rocketproplab/Remove-Before-Flight/README.md

# Remove Before Flight
"Remove Before Flight" RBF-1 is a 2000 lbf Liquid Oxygen, Liquid Natural Gas engine currently being designed and developed by the Rocket Propulsion Laboratory.
