rocketproplab/Remove-Before-Flight/CAD/Igniter_Assembly_3_11.SLDASM

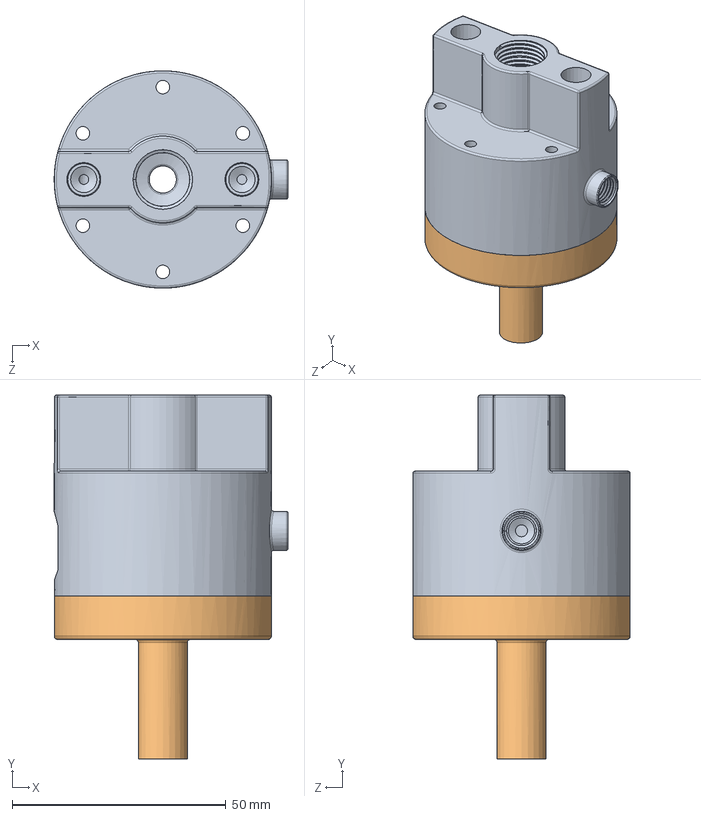
[picture p15: CAD file, 2017-03-30]
CAD/Igniter_Assembly_3_11.SLDASM
54.6 x 85.1 x 50.8 mm
Igniter_Top
Ingiter_Tube2
