rocketproplab/Remove-Before-Flight/CAD/IgniterBottom.SLDPRT

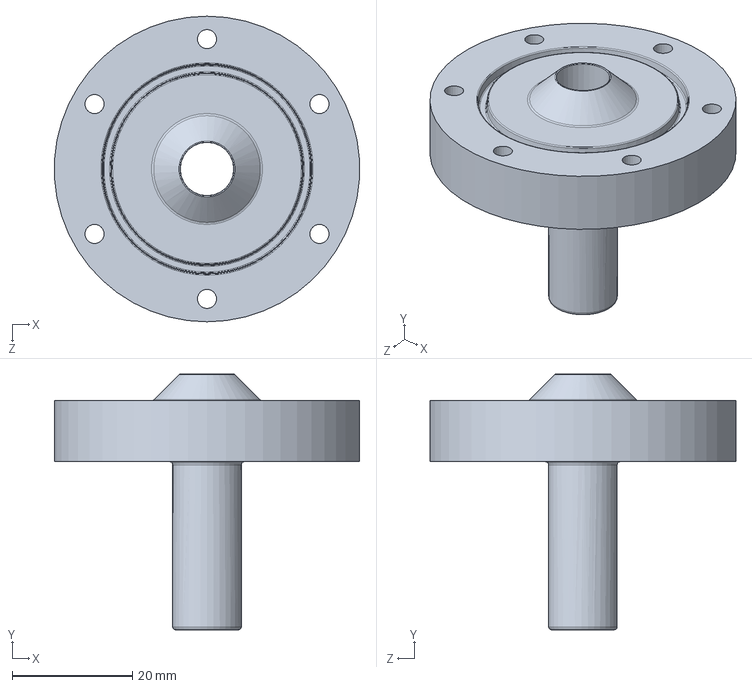
[picture p16: CAD file, 2017-03-30]
CAD/IgniterBottom.SLDPRT
50.7 x 42.5 x 50.8 mm
