rocketproplab/Remove-Before-Flight/CAD/Igniter_Top.SLDPRT

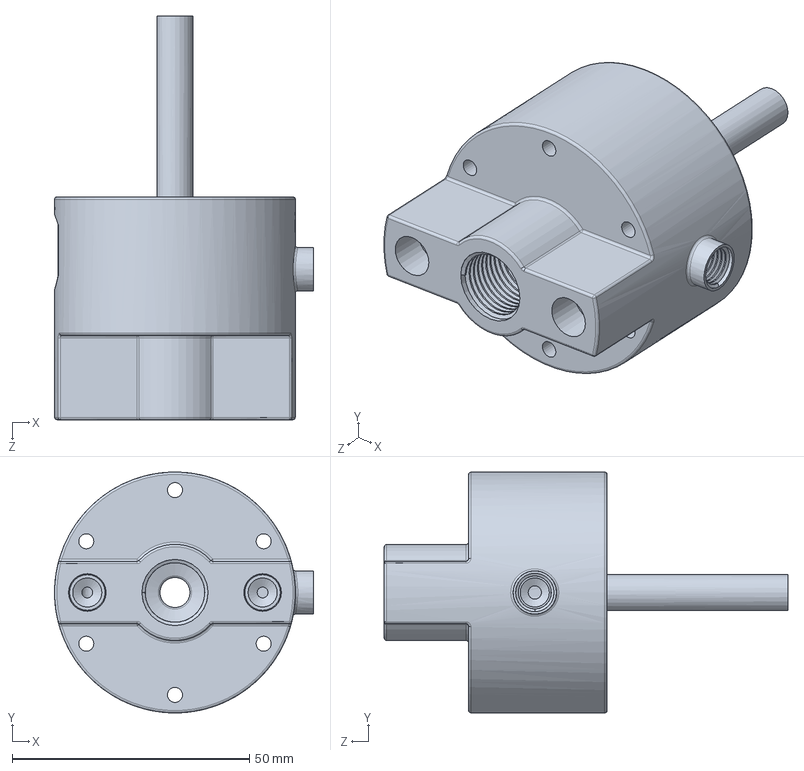
[picture p17: CAD file, 2017-03-30]
CAD/Igniter_Top.SLDPRT
54.6 x 50.8 x 85.1 mm
