rocketproplab/Remove-Before-Flight/CAD/Igniter_Flange.SLDPRT

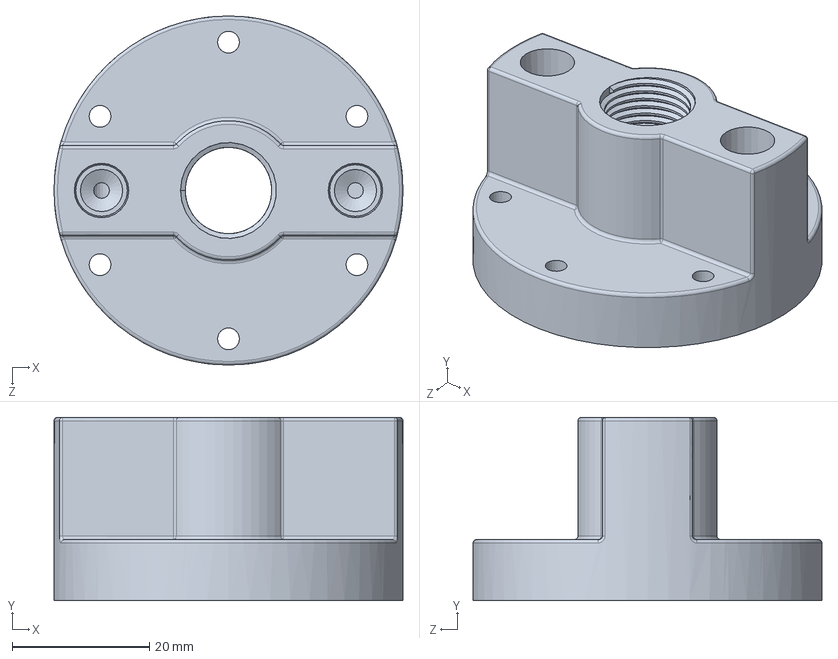
[picture p18: CAD file, 2017-03-30]
CAD/Igniter_Flange.SLDPRT
50.8 x 26.7 x 50.8 mm
