rocketproplab/Remove-Before-Flight/CAD/Igniter_Chamber2.SLDPRT

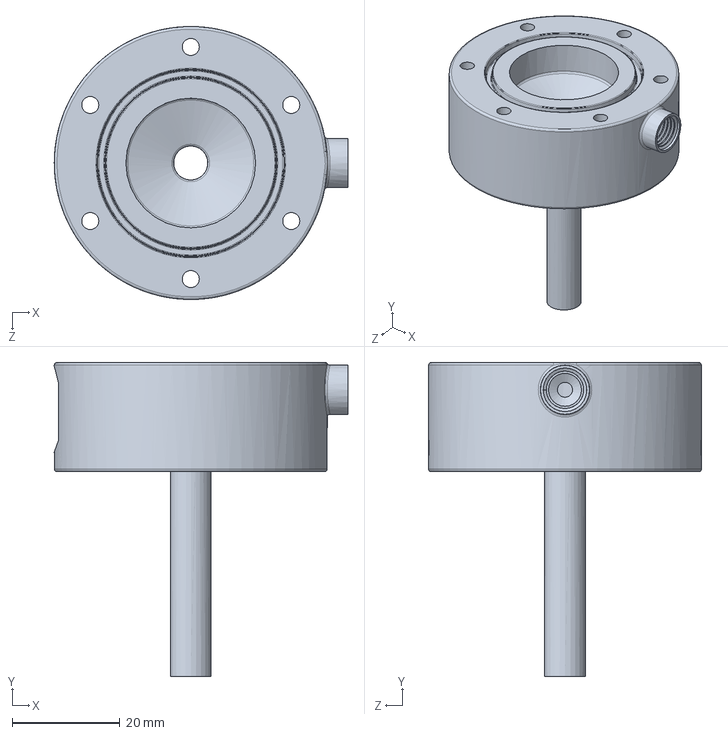
[picture p19: CAD file, 2017-03-30]
CAD/Igniter_Chamber2.SLDPRT
54.6 x 58.4 x 50.8 mm
