rocketproplab/Remove-Before-Flight/CAD/RPL00001-02_TCA_1000lbf.SLDPRT

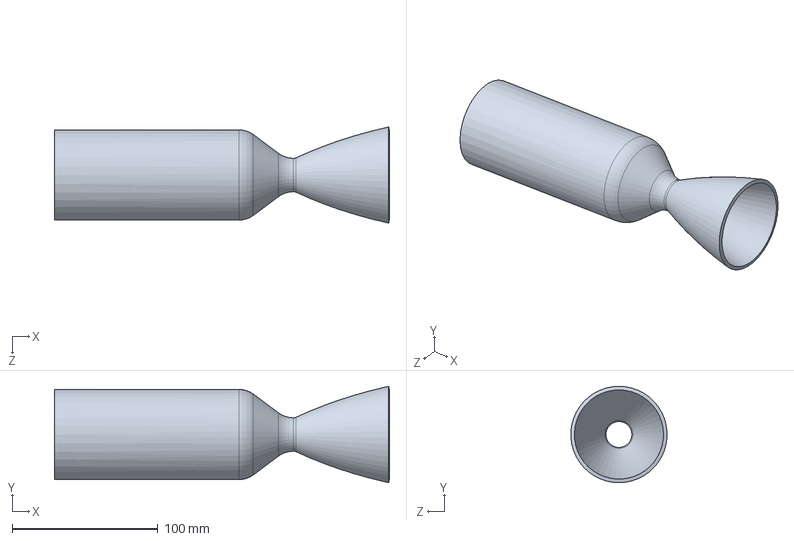
[picture p20: CAD file, 2017-03-30]
CAD/RPL00001-02_TCA_1000lbf.SLDPRT
229.8 x 66.1 x 66.0 mm
