rocketproplab/Remove-Before-Flight/CAD/RPL00001-01_TCA_500lbf.SLDPRT

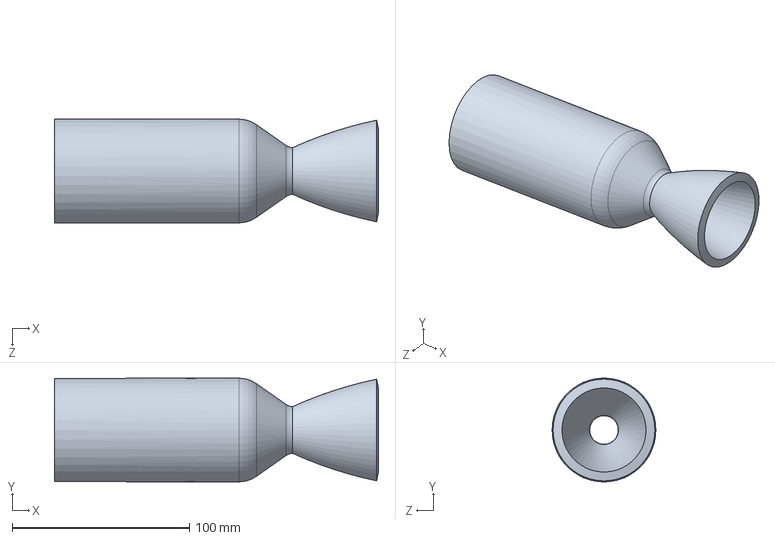
[picture p21: CAD file, 2017-03-30]
CAD/RPL00001-01_TCA_500lbf.SLDPRT
182.6 x 58.5 x 58.5 mm
