rocketproplab/Remove-Before-Flight/(list of files, cad)

Other CAD files:
CAD/RPL00001-02_TCA_1000lbf.SLDDRW
